itpick/openprint-build/parts/img/carriage.png

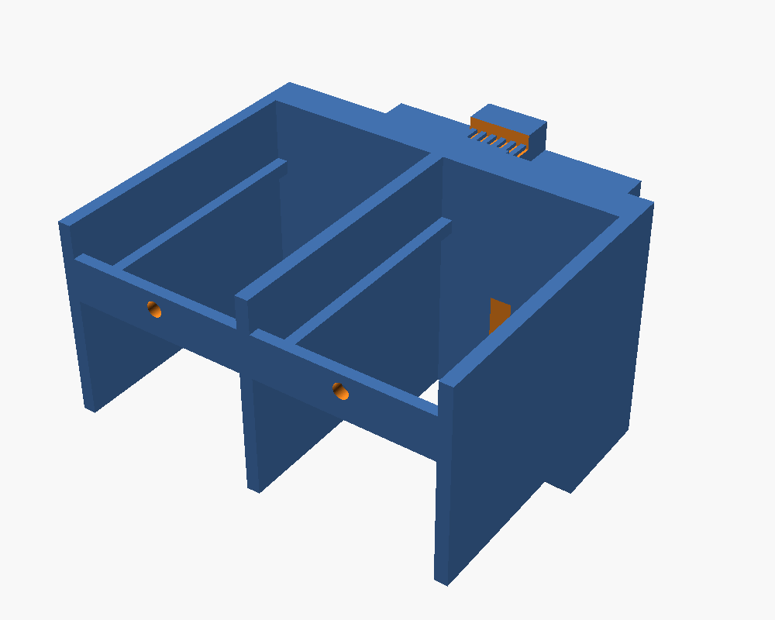
parts/img/carriage.png
