itpick/openprint-build/parts/img/frame_left.png

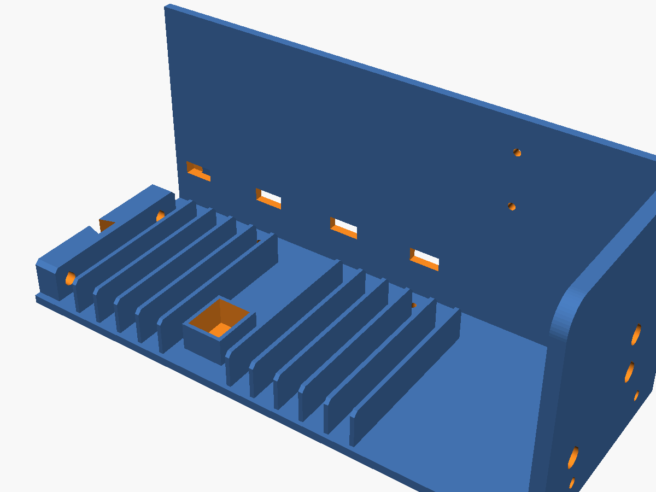
parts/img/frame_left.png
