itpick/openprint-build/parts/img/frame_right.png

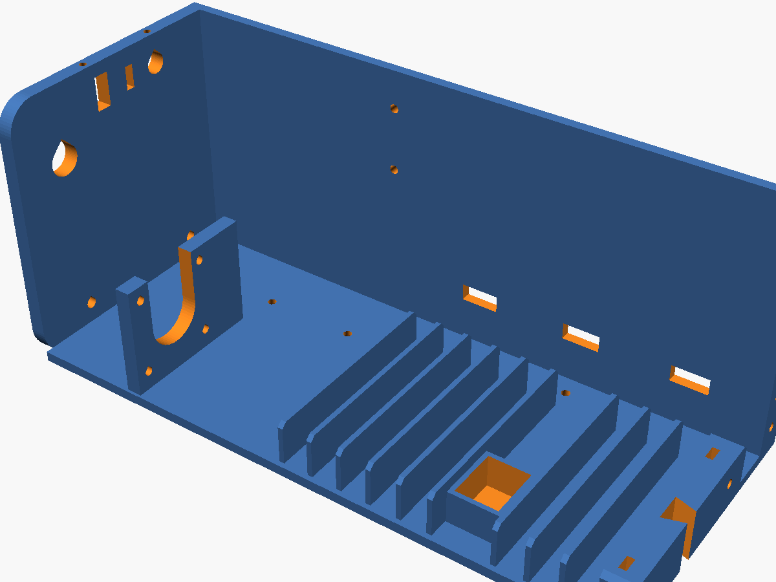
parts/img/frame_right.png
