itpick/openprint-build/parts/stl/paper_ramp.stl

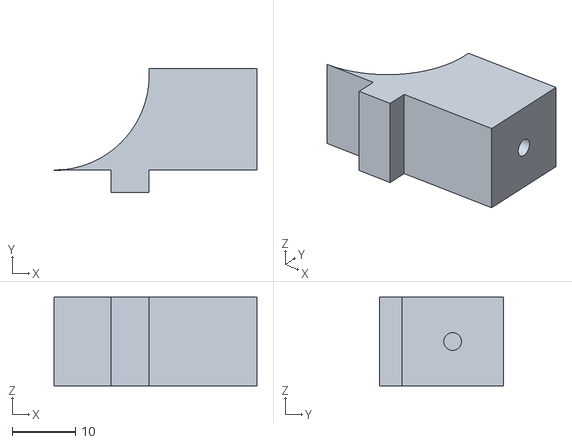
[picture p6: CAD file, 2026-10-13]
parts/stl/paper_ramp.stl
32.0 x 19.5 x 14.0
