itpick/openprint-build/parts/stl/encoder_knob.stl

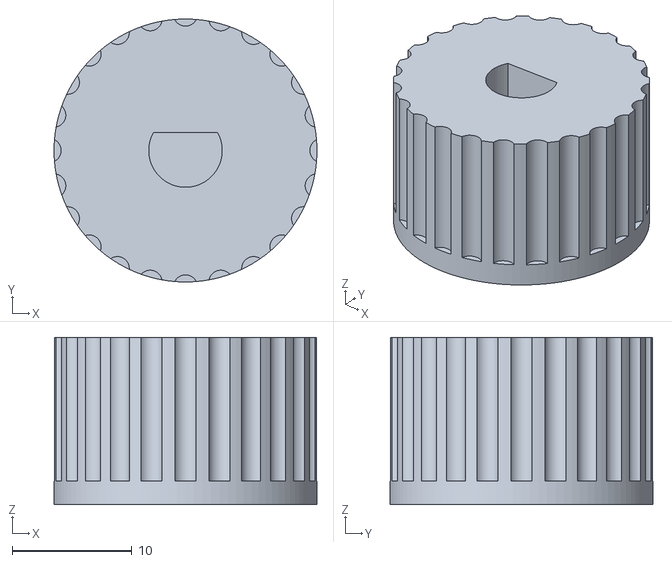
[picture p7: CAD file, 2026-10-13]
parts/stl/encoder_knob.stl
22.0 x 22.0 x 14.0
