itpick/openprint-build/parts/stl/roll_hub.stl

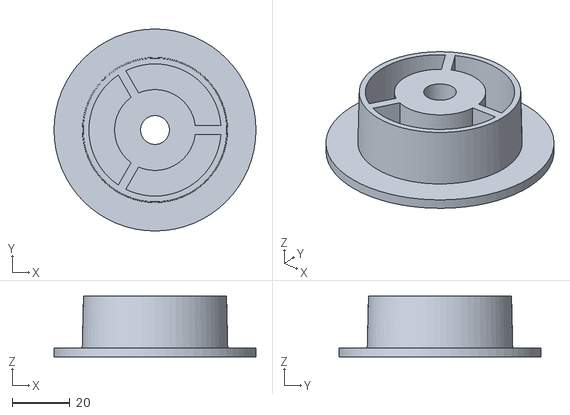
[picture p8: CAD file, 2026-10-13]
parts/stl/roll_hub.stl
70.0 x 70.0 x 21.0
