itpick/openprint-build/parts/stl/frame_left.stl

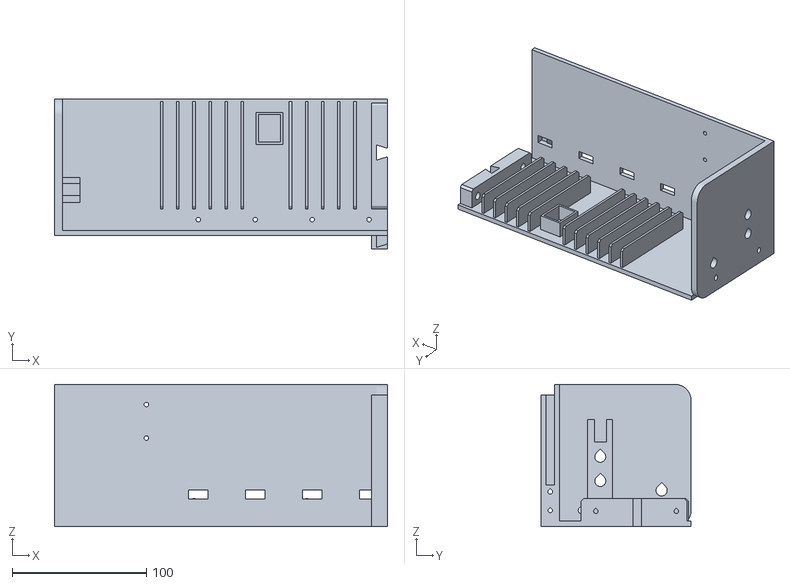
[picture p9: CAD file, 2026-10-13]
parts/stl/frame_left.stl
248.2 x 112.0 x 106.0
