itpick/openprint-build/parts/stl/roll_axle.stl

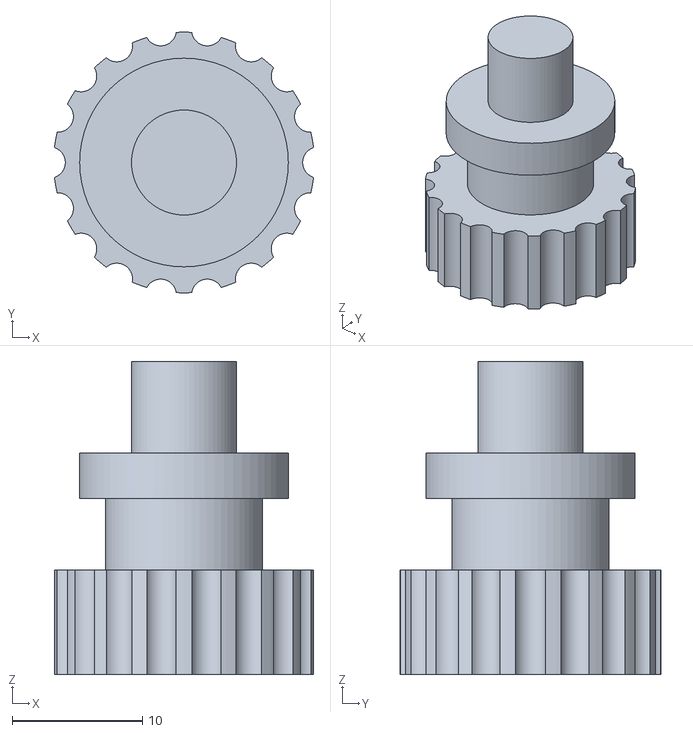
[picture p10: CAD file, 2026-10-13]
parts/stl/roll_axle.stl
19.9 x 20.0 x 24.0
