itpick/openprint-build/parts/stl/motor_mount.stl

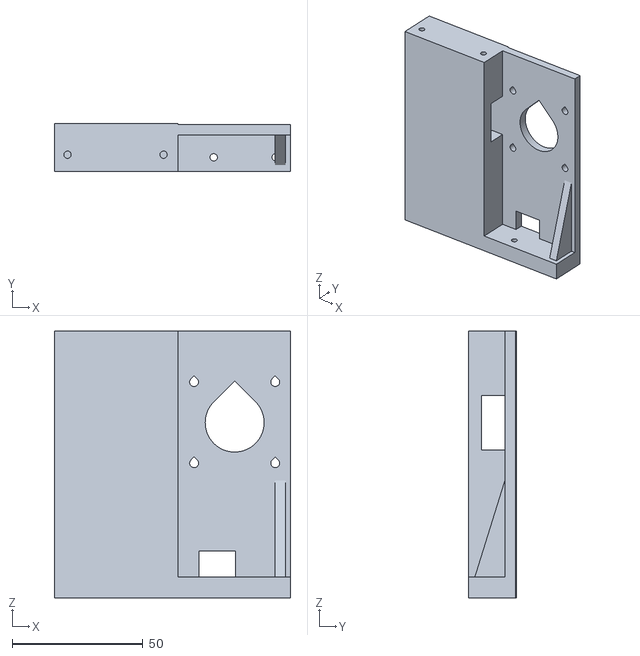
[picture p11: CAD file, 2026-10-13]
parts/stl/motor_mount.stl
90.2 x 18.5 x 102.0
