itpick/openprint-build/parts/stl/roll_arm_right.stl

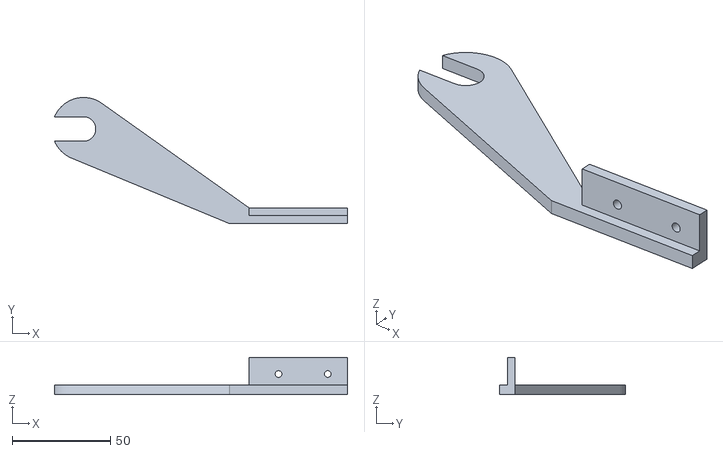
[picture p12: CAD file, 2026-10-13]
parts/stl/roll_arm_right.stl
148.7 x 64.0 x 19.0
