itpick/openprint-build/parts/stl/display_pod.stl

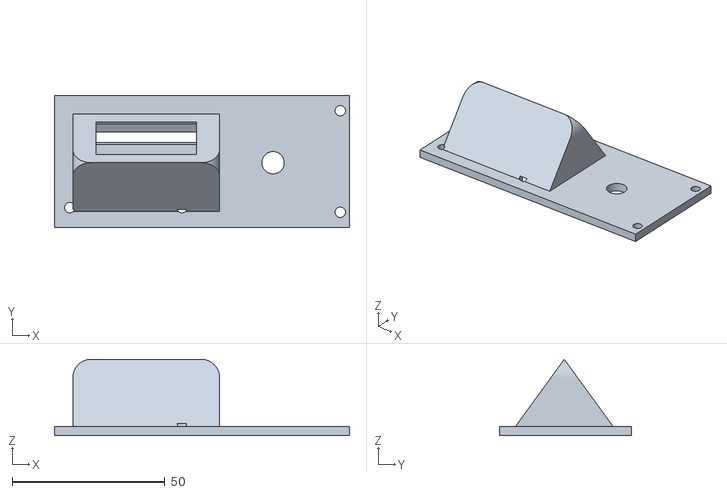
[picture p13: CAD file, 2026-10-13]
parts/stl/display_pod.stl
96.5 x 43.2 x 25.0
