itpick/openprint-build/parts/stl/pi_zero_mount.stl

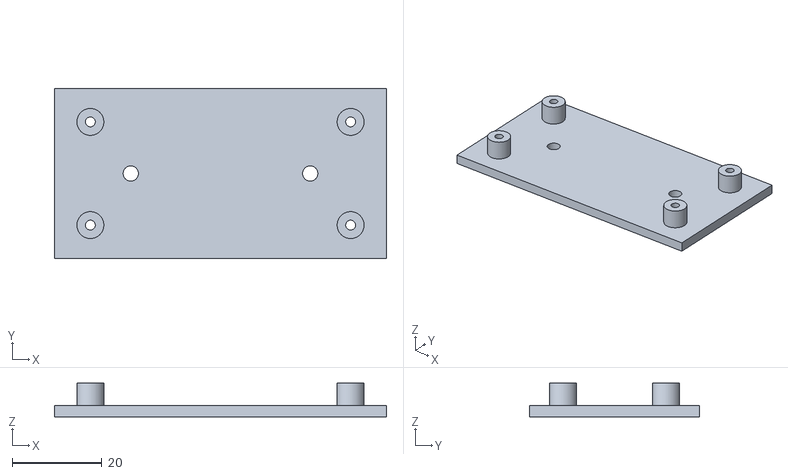
[picture p14: CAD file, 2026-10-13]
parts/stl/pi_zero_mount.stl
74.0 x 38.0 x 7.50
