itpick/openprint-build/parts/stl/carriage.stl

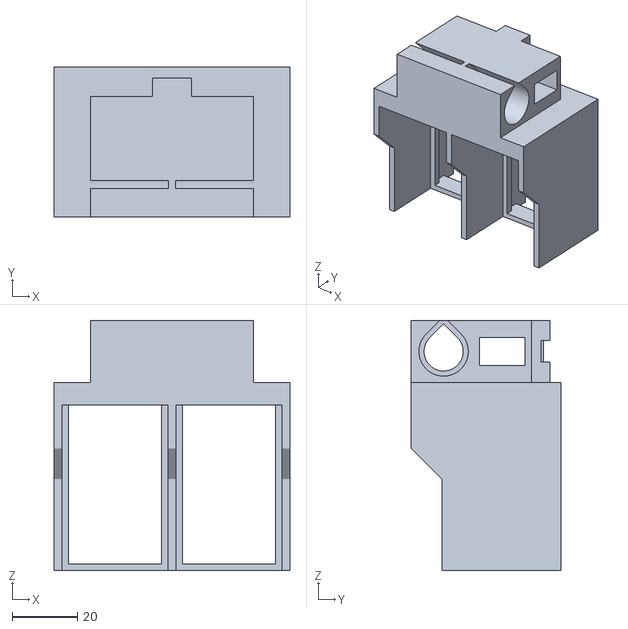
[picture p15: CAD file, 2026-10-13]
parts/stl/carriage.stl
72.4 x 46.0 x 76.7
