itpick/openprint-build/parts/stl/feed_roller.stl

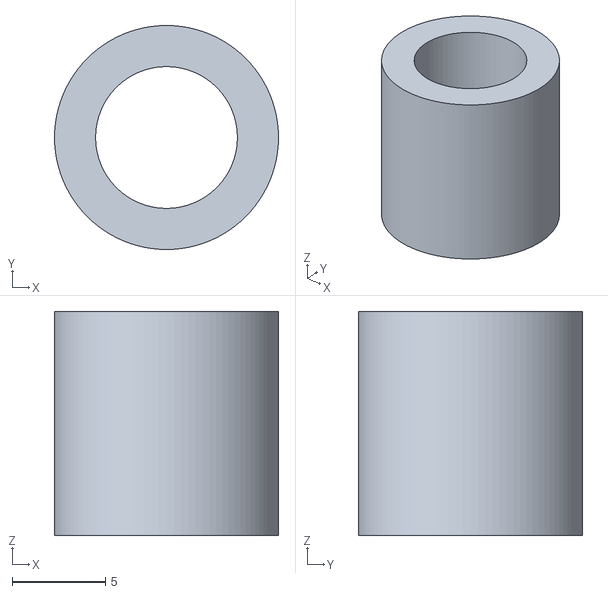
[picture p16: CAD file, 2026-10-13]
parts/stl/feed_roller.stl
12.0 x 12.0 x 12.0
