itpick/openprint-build/parts/stl/joint_key_back.stl

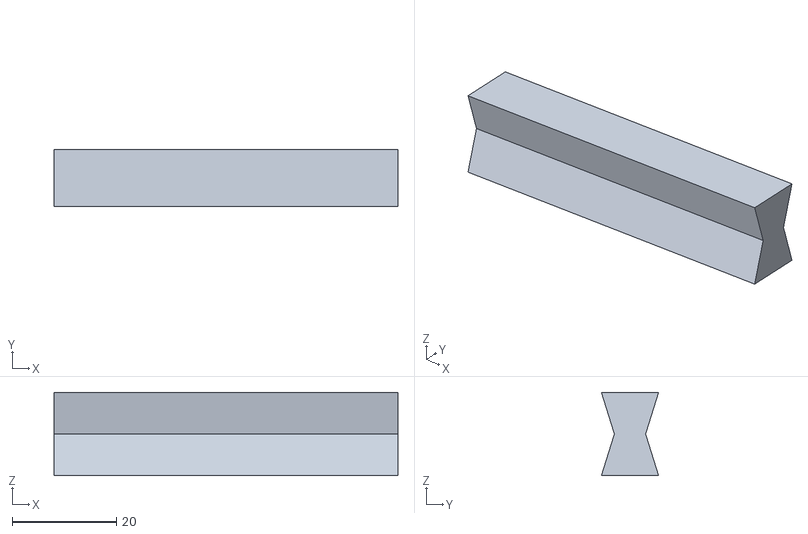
[picture p17: CAD file, 2026-10-13]
parts/stl/joint_key_back.stl
66.0 x 11.0 x 16.0
