itpick/openprint-build/parts/stl/joint_key_platen.stl

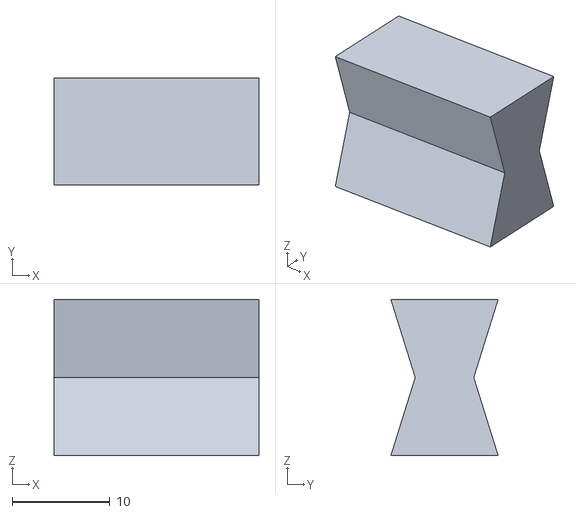
[picture p18: CAD file, 2026-10-13]
parts/stl/joint_key_platen.stl
21.0 x 11.0 x 16.0
