itpick/openprint-build/parts/stl/cart_fit_gauge.stl

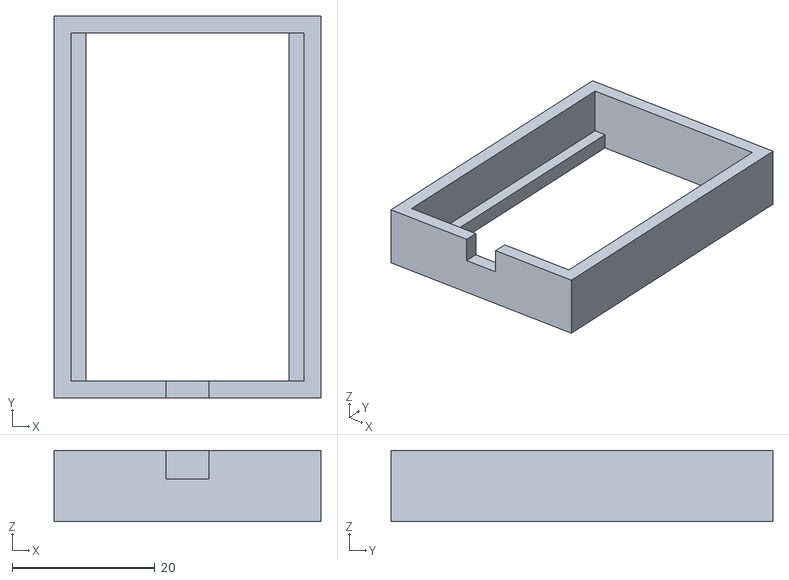
[picture p19: CAD file, 2026-10-13]
parts/stl/cart_fit_gauge.stl
37.4 x 53.5 x 10.0
