itpick/openprint-build/parts/stl/pinch_pad.stl

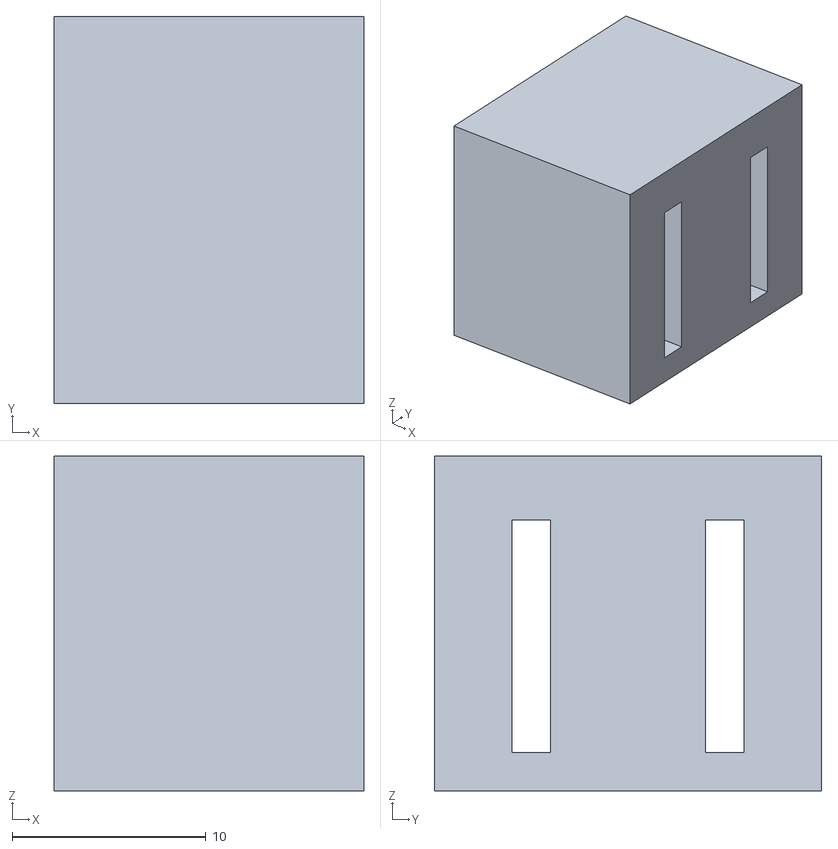
[picture p20: CAD file, 2026-10-13]
parts/stl/pinch_pad.stl
16.0 x 20.0 x 17.3
