itpick/openprint-build/parts/stl/pinch_spacer_0.stl

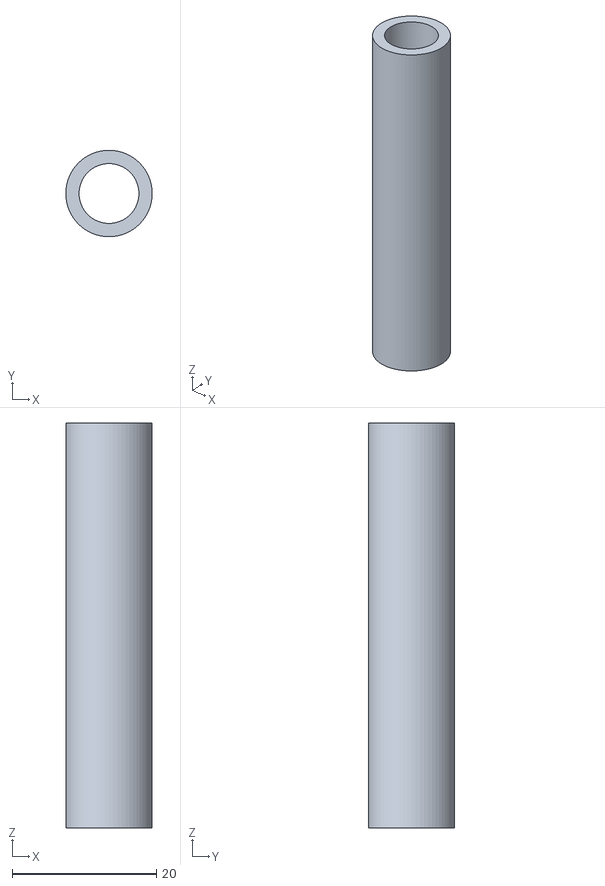
[picture p21: CAD file, 2026-10-13]
parts/stl/pinch_spacer_0.stl
12.0 x 12.0 x 56.2
