itpick/openprint-build/parts/stl/pinch_spacer_1.stl

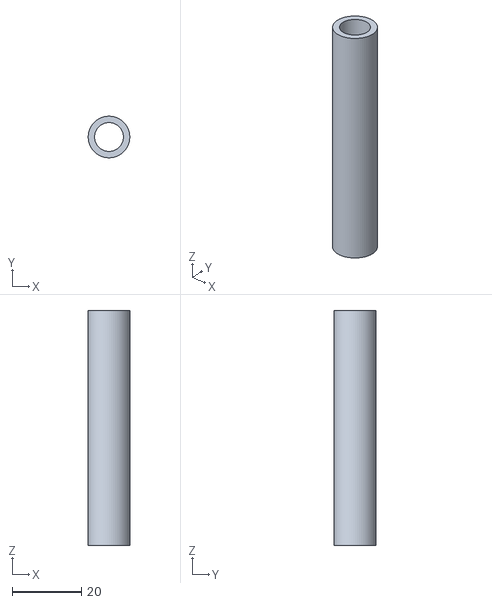
[picture p22: CAD file, 2026-10-13]
parts/stl/pinch_spacer_1.stl
12.0 x 12.0 x 67.7
