itpick/openprint-build/parts/stl/pinch_spacer_2.stl

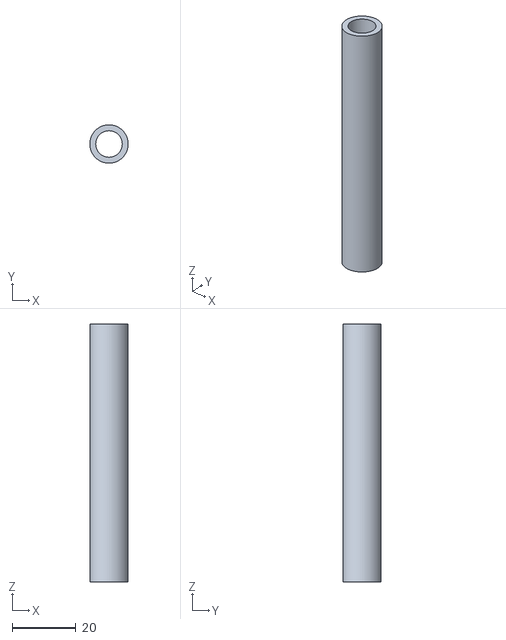
[picture p23: CAD file, 2026-10-13]
parts/stl/pinch_spacer_2.stl
12.0 x 12.0 x 80.7
