itpick/openprint-build/parts/stl/pinch_spacer_3.stl

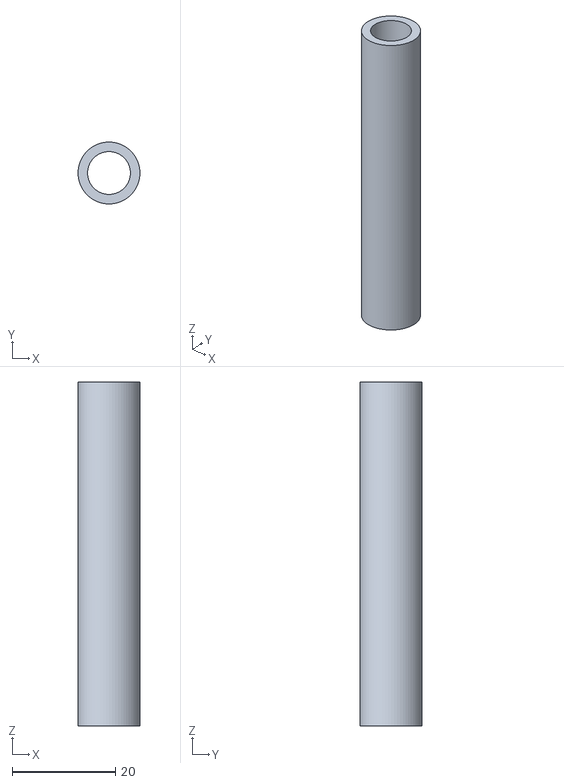
[picture p24: CAD file, 2026-10-13]
parts/stl/pinch_spacer_3.stl
12.0 x 12.0 x 66.7
