itpick/openprint-build/parts/stl/pinch_spacer_4.stl

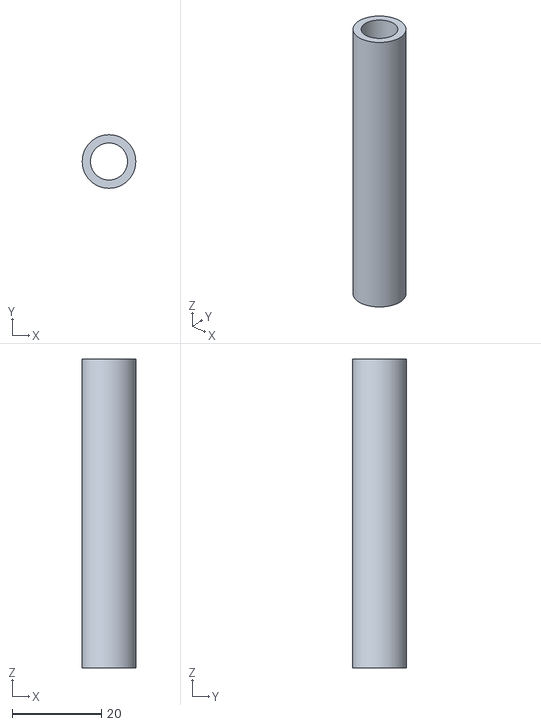
[picture p25: CAD file, 2026-10-13]
parts/stl/pinch_spacer_4.stl
12.0 x 12.0 x 69.2
