itpick/openprint-build/parts/stl/splice_back.stl

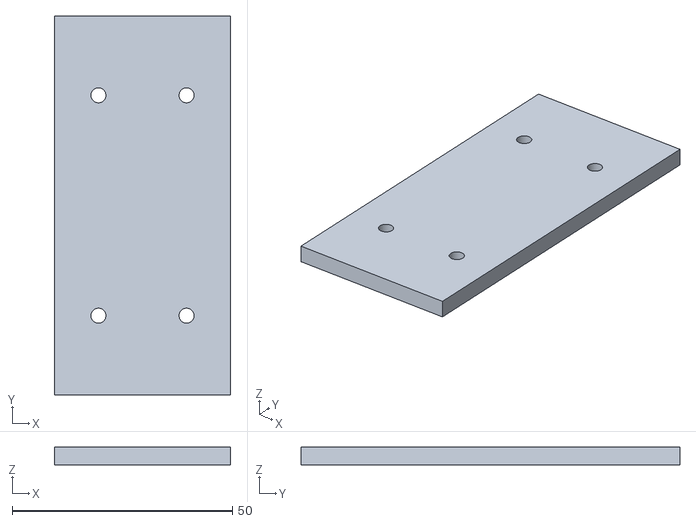
[picture p26: CAD file, 2026-10-13]
parts/stl/splice_back.stl
40.0 x 86.0 x 4.00
