itpick/openprint-build/parts/stl/feed_sleeve.stl

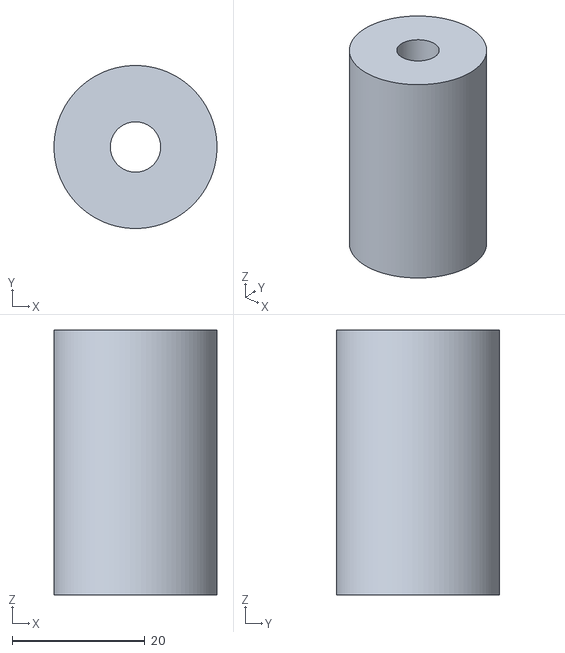
[picture p27: CAD file, 2026-10-13]
parts/stl/feed_sleeve.stl
24.6 x 24.6 x 40.0
