itpick/openprint-build/parts/stl/frame_mid.stl

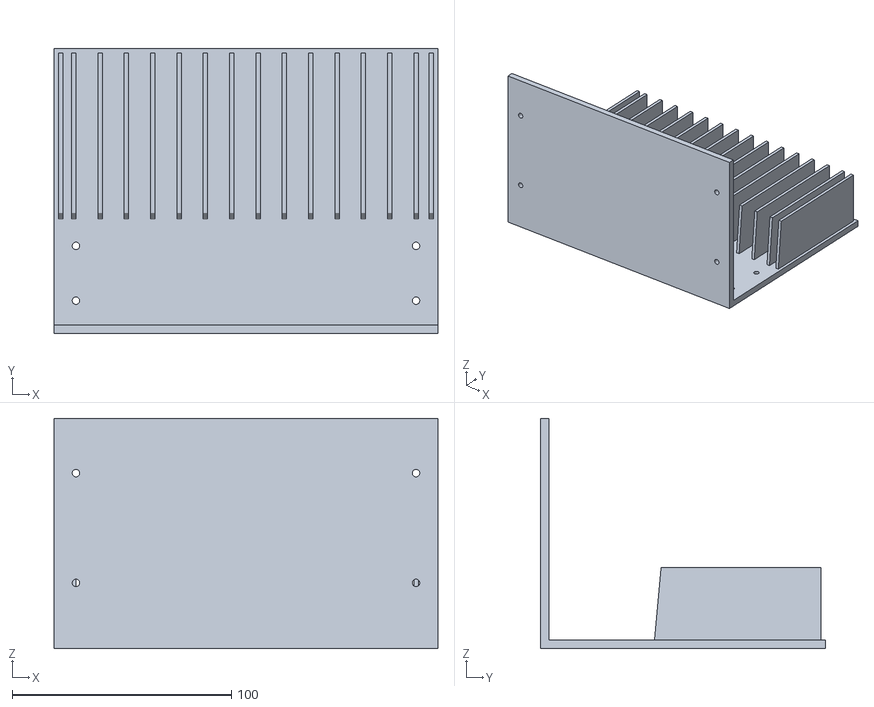
[picture p28: CAD file, 2026-10-13]
parts/stl/frame_mid.stl
175.0 x 130.0 x 105.0
