itpick/openprint-build/parts/stl/splice_floor.stl

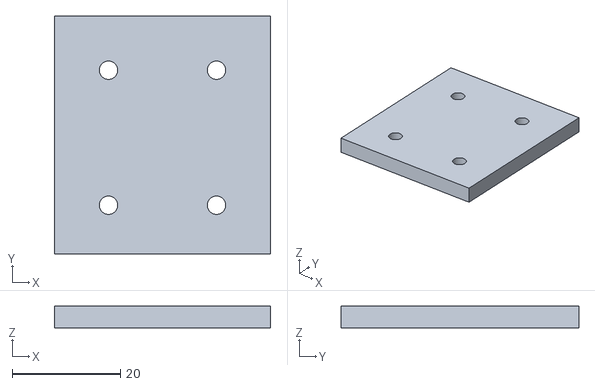
[picture p29: CAD file, 2026-10-13]
parts/stl/splice_floor.stl
40.0 x 44.0 x 4.00
