itpick/openprint-build/(list of files, cad)

Other CAD files:
parts/stl/frame_right.stl
parts/stl/roll_arm_left.stl
