itpick/openprint-build/(commit log)

2026-10-13 Add build notes: product spec, parts inventory, founders, prior art
    Research summary of the Open Tools Openprinter (open-source inkjet,
    Paris): published specs and part inventory, team background, GitHub
    search results for existing builds (none; YTEC HP45 + SpritesMods are
    the buildable prior art), and Prusa CORE One case-printing assessment.
2026-10-13 Add v0 printable parts: PETG frame, carriage, feed and roll parts
    Parametric OpenSCAD design following the Openprinter layout seen in Open
    Tools' photos and assembly video (their CAD is unpublished). Three-section
    PETG tray that fits a CORE One bed, front-loading carriage for HP 63/302 on
    8 mm rods + LM8UU, GT2 belt, coupler-driven feed roller with TPU sleeves over
    608 pinch bearings, roll hubs, splice plates, Pi Zero mount, EC11 knob.
    All STLs are watertight and fit the bed; assembly.scad interference checks
    pass. Untested in print. Cartridge dimensions are estimates; print
    cart_fit_gauge first.
2026-10-13 Rebuild printable parts to match the Openprinter (v2)
    Measured from Open Tools' own material: their chassis drawing (496.5 long,
    102 x 106 end profile, R12 corners), the dimension renders, the see-through
    CAD front view of the right end, cover-off press photos and the Crowd Supply
    assembly video. Cartridge geometry comes from a 3D scan of an HP 123 (same
    shell as the 63/302/803).
    - Frame: 496.5 mm envelope in two 248.25 mm halves that fit a CORE One bed,
    joined with butterfly keys and M3 screws; R12 end walls, back-wall slot row,
    right-end port cutouts
    - Carriage: real-size cartridges hung by their ears in front of a contact
    plate; rods and belt behind, belt clamp on top
    - Right end: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
2026-10-13 Add display pod, motor mount and paper ramps
    - display_pod: the black LCD wedge on top of the right end (measured 48 wide,
    ~22 tall), window for the Waveshare 1.47" LCD on its sloped face, deck with
    the EC11 encoder hole for the knob
    - motor_mount: the carriage motor plate and right rod ends split out of
    frame_right as a separate bracket, like the Openprinter's; bolts to the
    floor and carries the display pod deck
    - paper_ramp (x7): the white curved guides along the back of the platen,
    hooked into back-wall slots; the platen ribs are now flat
    - assembly.scad: 17 checks (adds the display pod), all empty
2026-10-13 Add PrusaSlicer screenshot of the printable parts to the README
2026-10-16 Add offline conversions of RansomLeak SCORM courses + converter tool
    The shipped packages iframe a hosted player and fetch content at
    runtime. The converter mirrors the player bundle (chunks, 3D models,
    audio, fonts, draco/basis decoders, simulated OS shells), extracts each
    course's exercise payload via the launch endpoint, and emits flat
    iframe-free index.html pages with a network lock (cross-origin
    fetch/XHR/WS/beacon rejected) and a localStorage SCORM driver.
    Verified offline via headless-Chromium netlog: zero page requests to
    external hosts.
